AlexGyver/GyverControl/docs/pinout.jpg

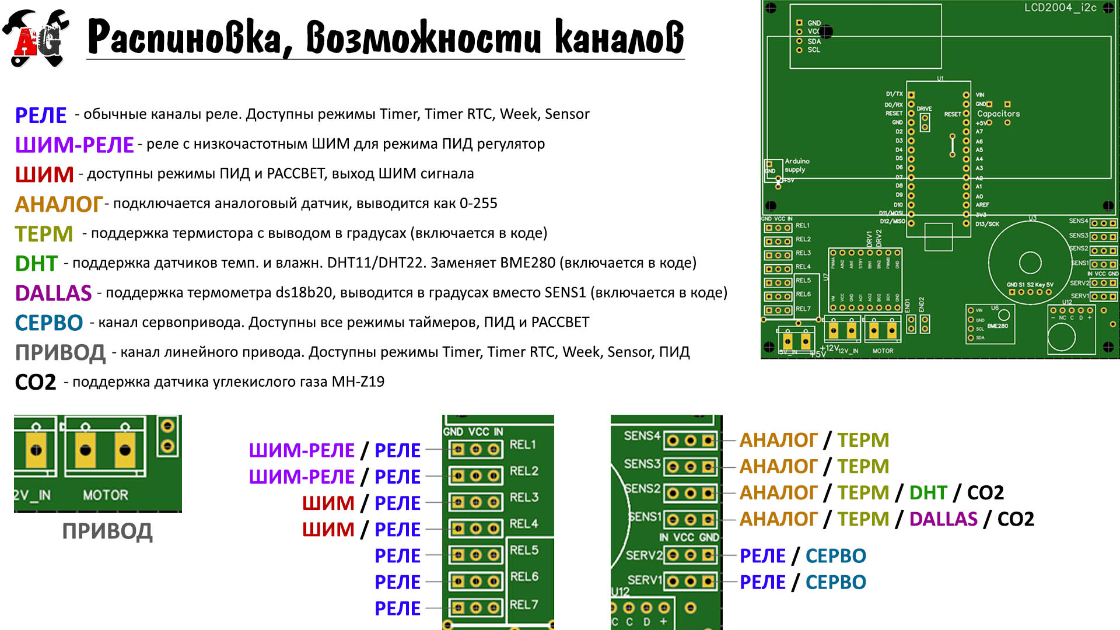
docs/pinout.jpg
