AlexGyver/GyverControl/docs/screen2.jpg

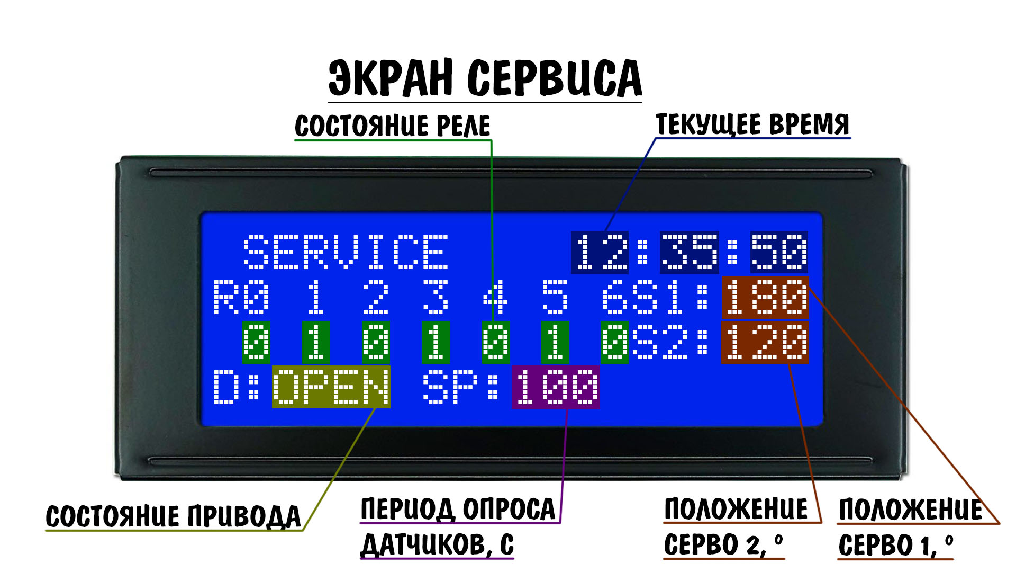
docs/screen2.jpg
