AlexGyver/GyverControl/docs/screen3.jpg

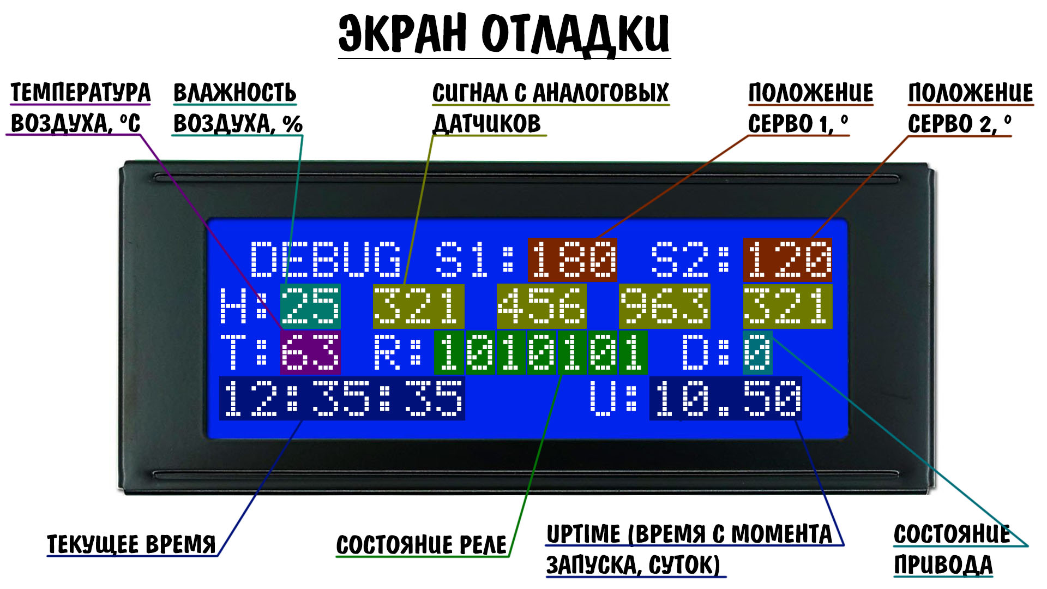
docs/screen3.jpg
