AlexGyver/GyverControl/docs/screen4.jpg

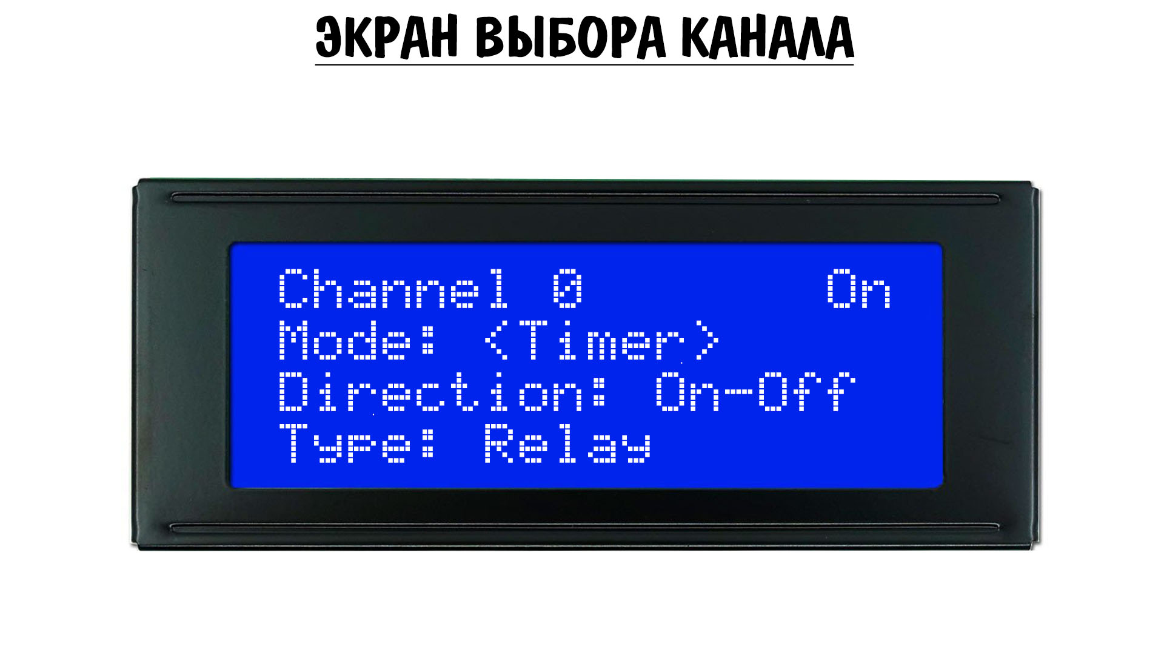
docs/screen4.jpg
