AlexGyver/GyverControl/docs/screen5.jpg

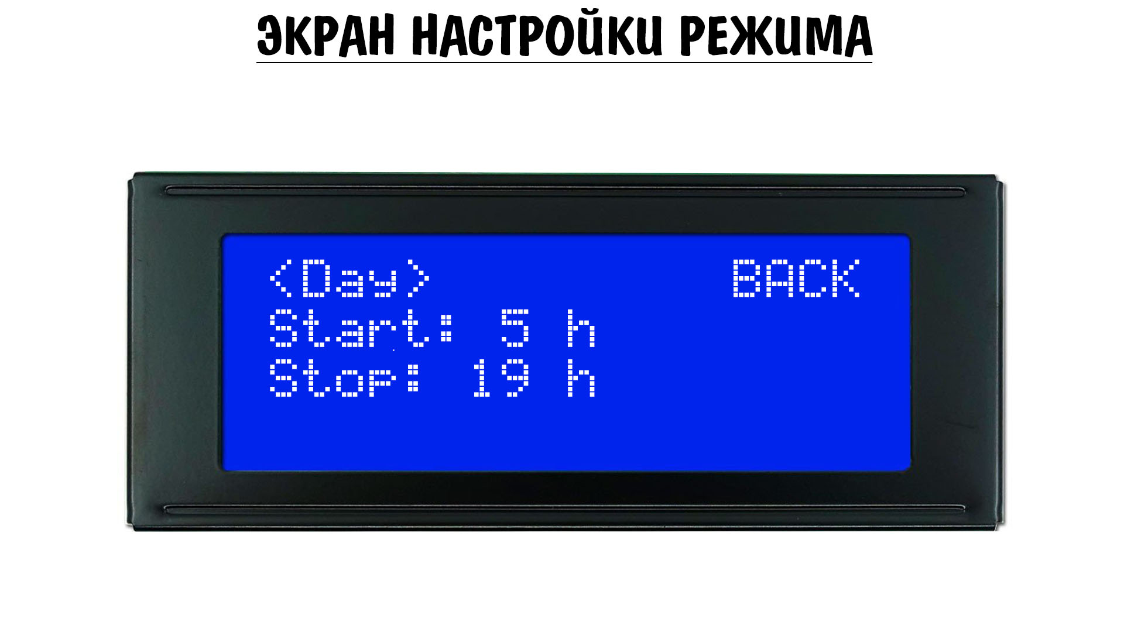
docs/screen5.jpg
