AlexGyver/GyverControl/docs/screen6.jpg

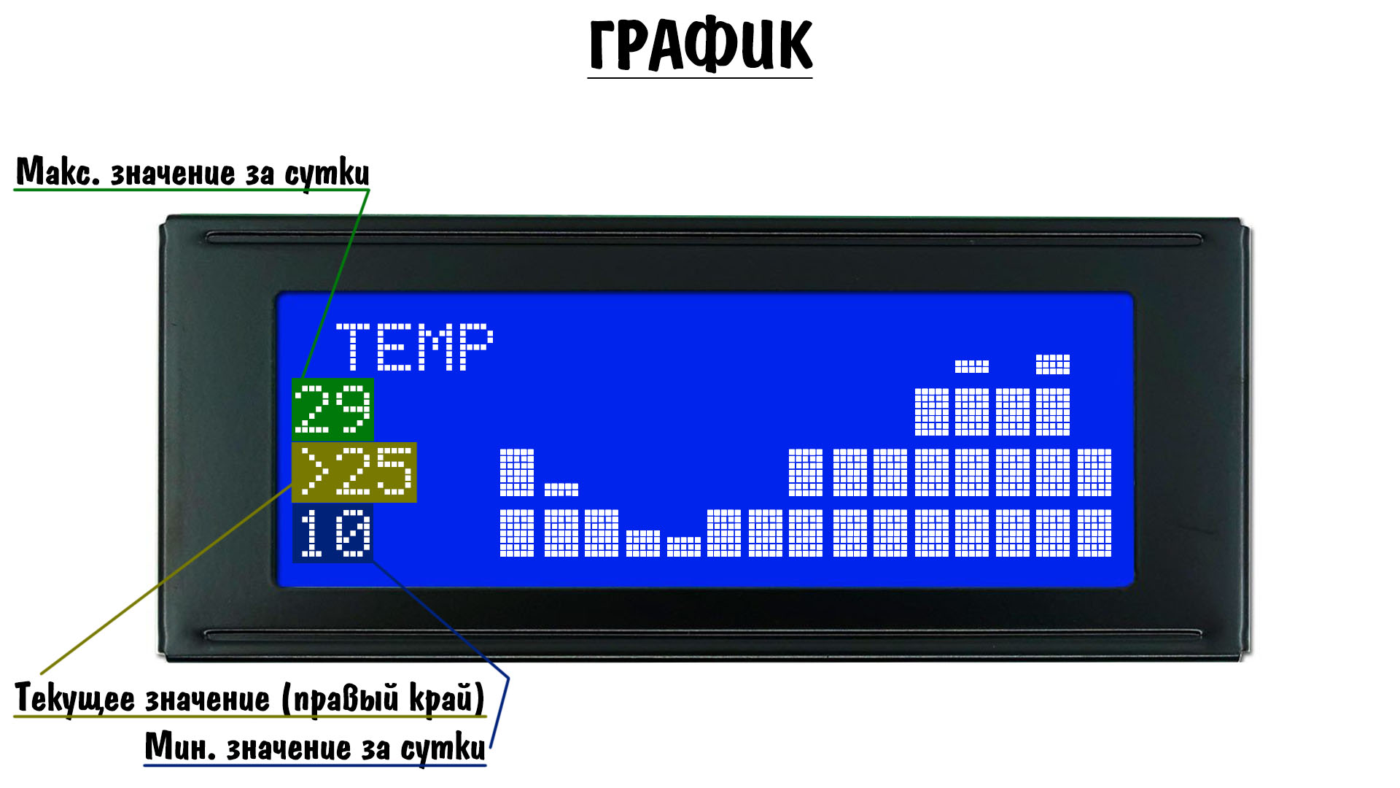
docs/screen6.jpg
