AlexGyver/GyverControl/docs/screen7.jpg

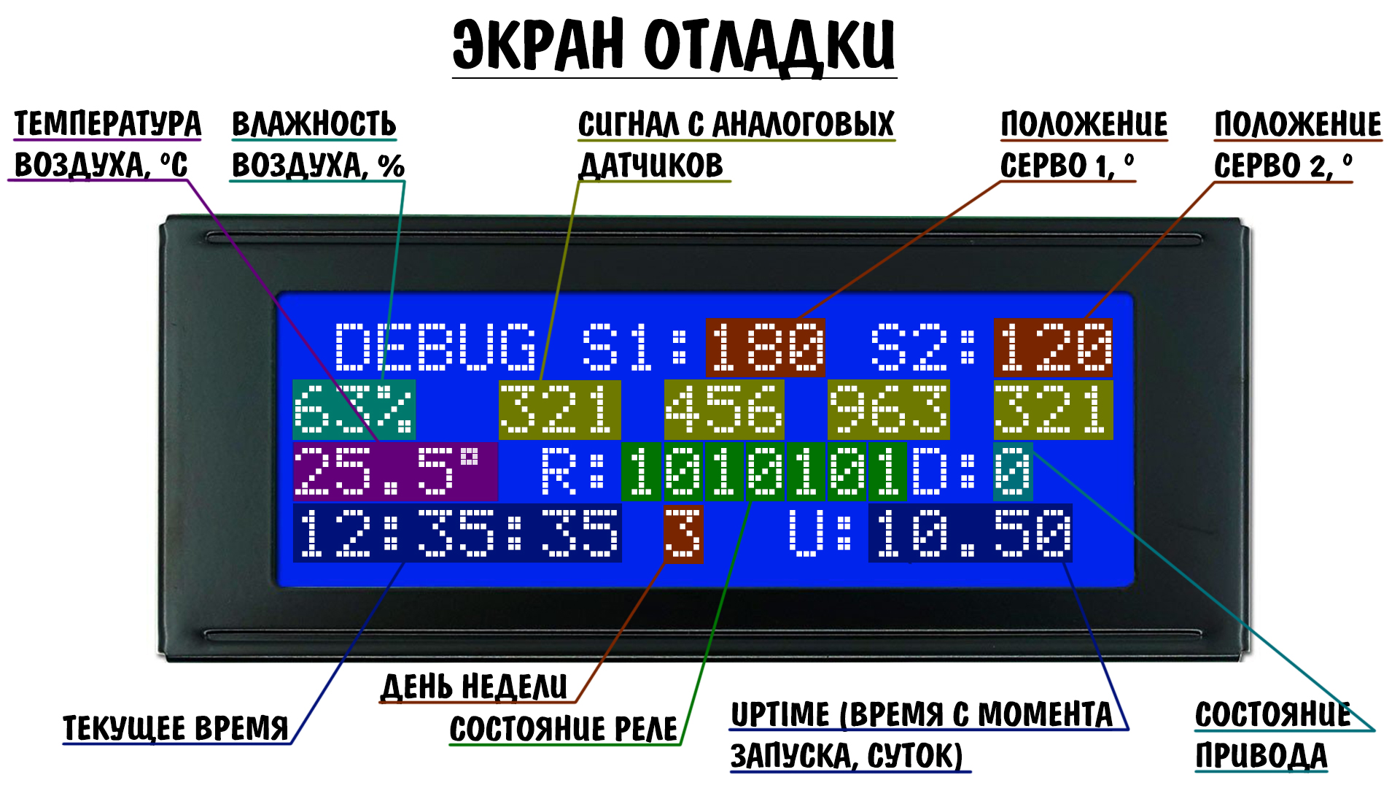
docs/screen7.jpg
