AlexGyver/GyverControl/schemes/scheme2.jpg

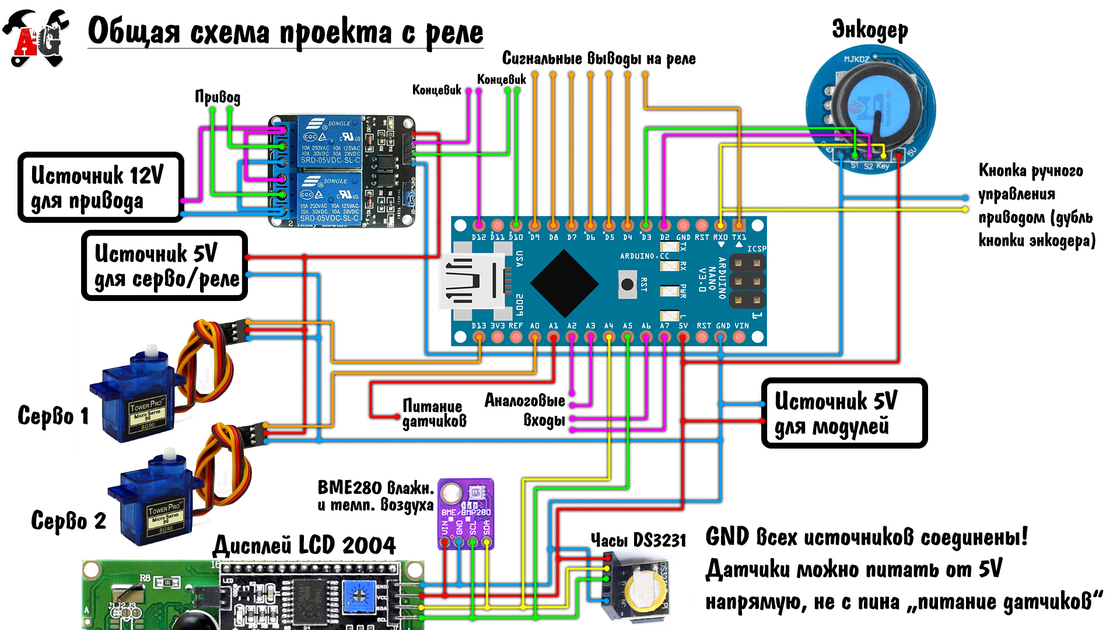
schemes/scheme2.jpg
