AlexGyver/GyverControl/schemes/scheme7.jpg

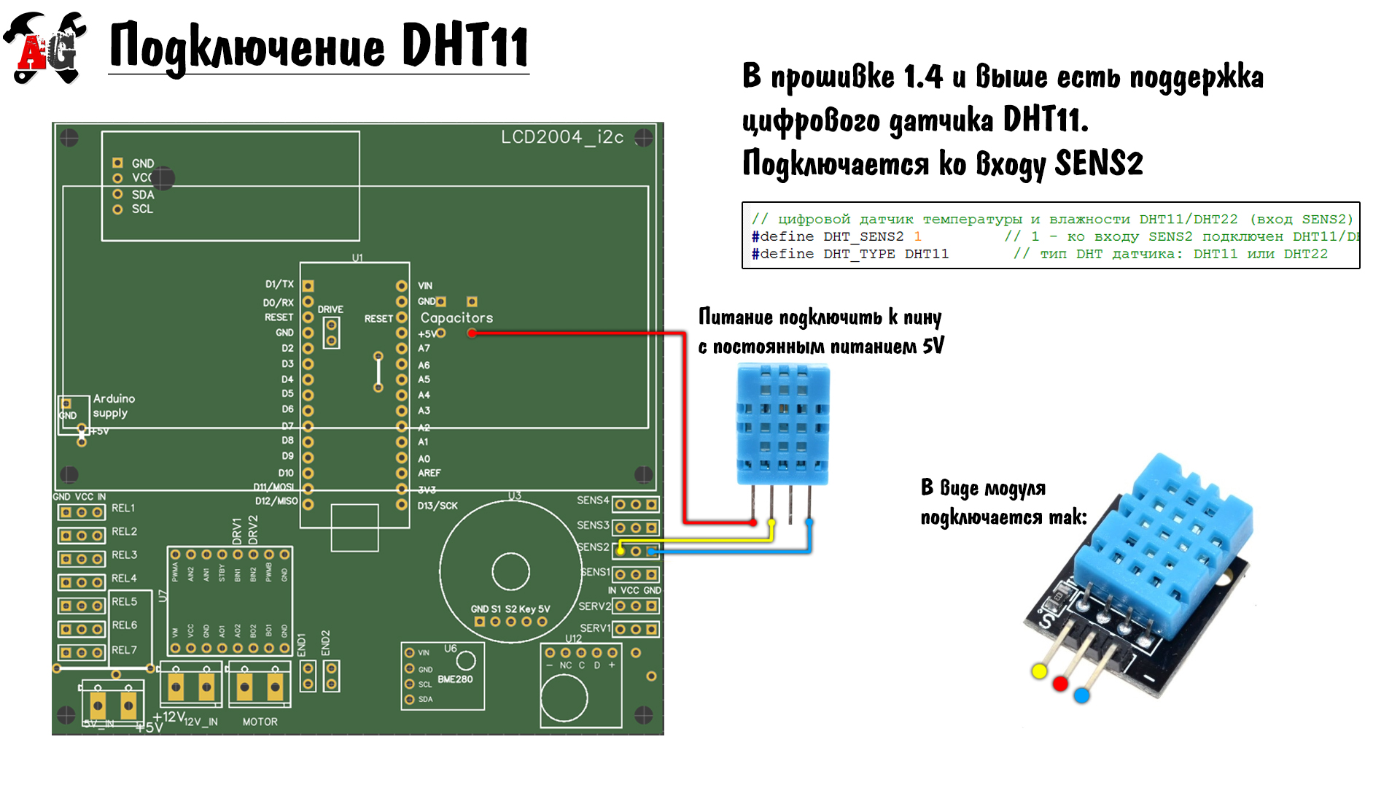
schemes/scheme7.jpg
