AlexGyver/GyverControl/schemes/scheme8.jpg

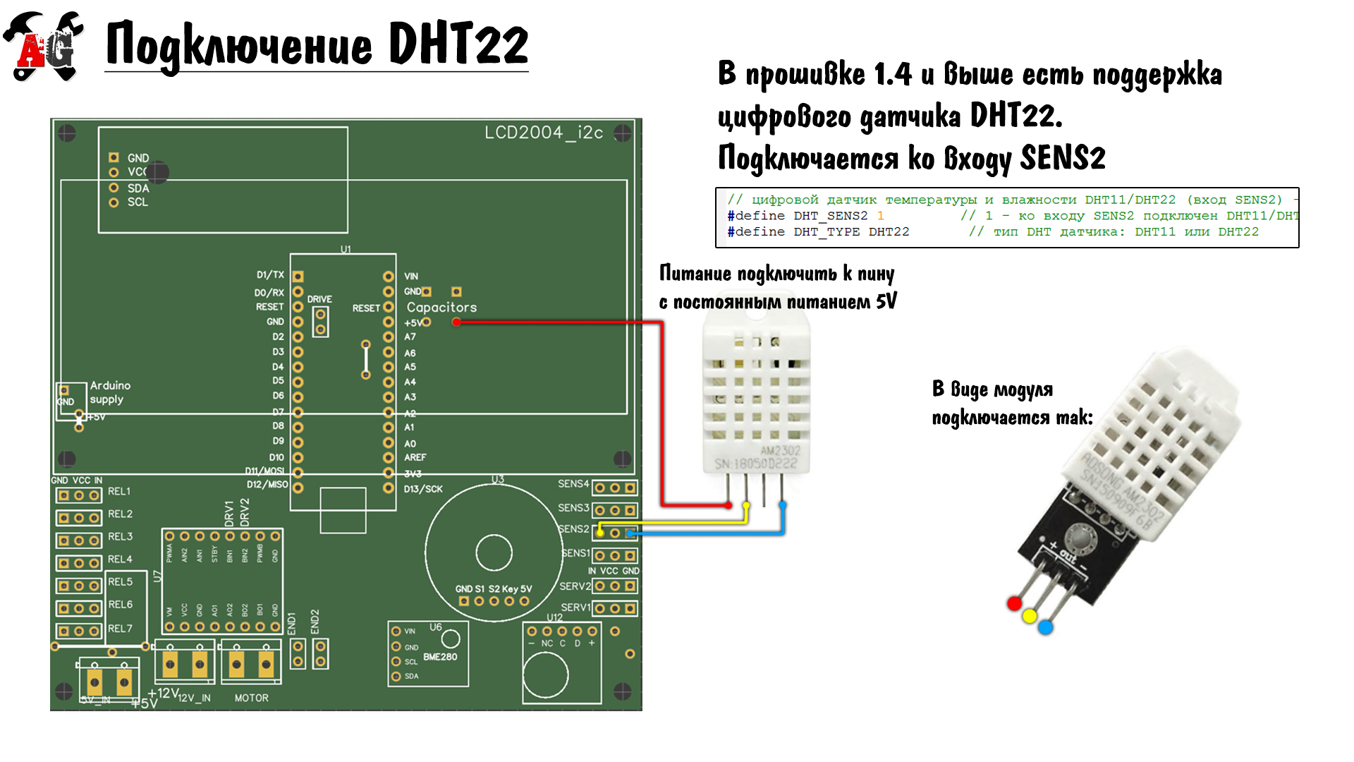
schemes/scheme8.jpg
