AlexGyver/GyverControl/schemes/scheme9.jpg

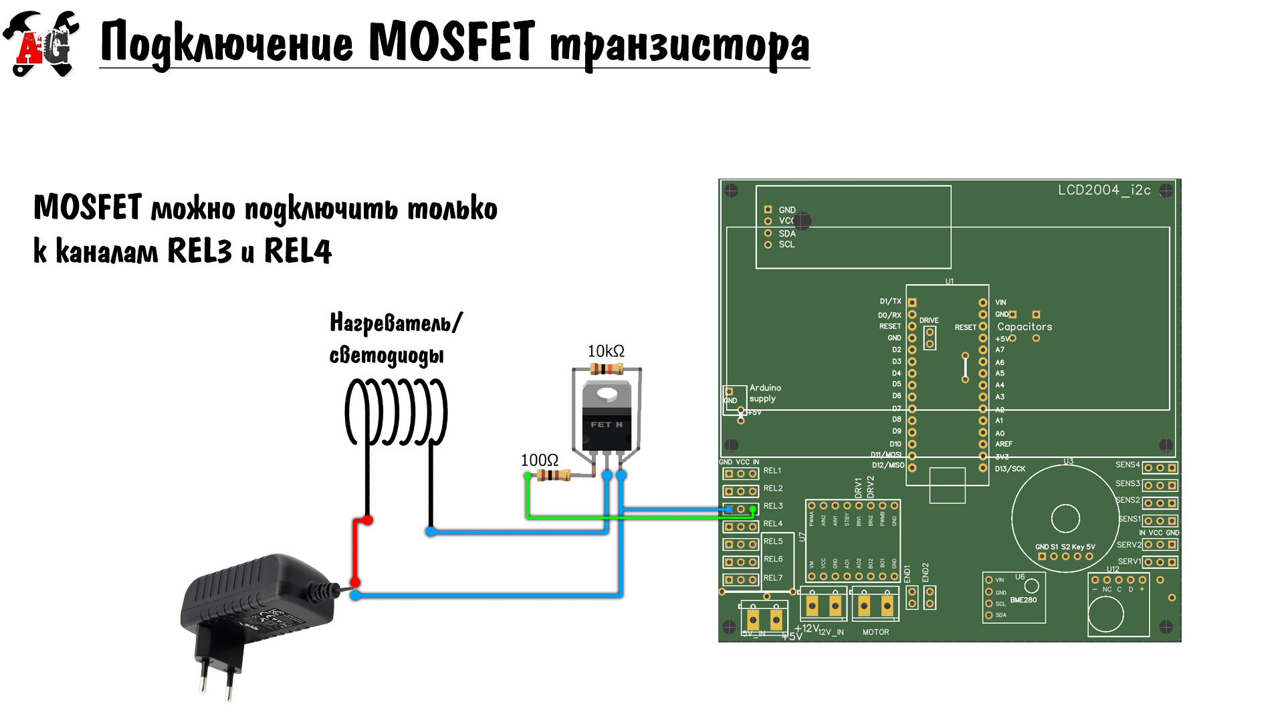
schemes/scheme9.jpg
