AlexGyver/GyverControl/schemes/scheme12.jpg

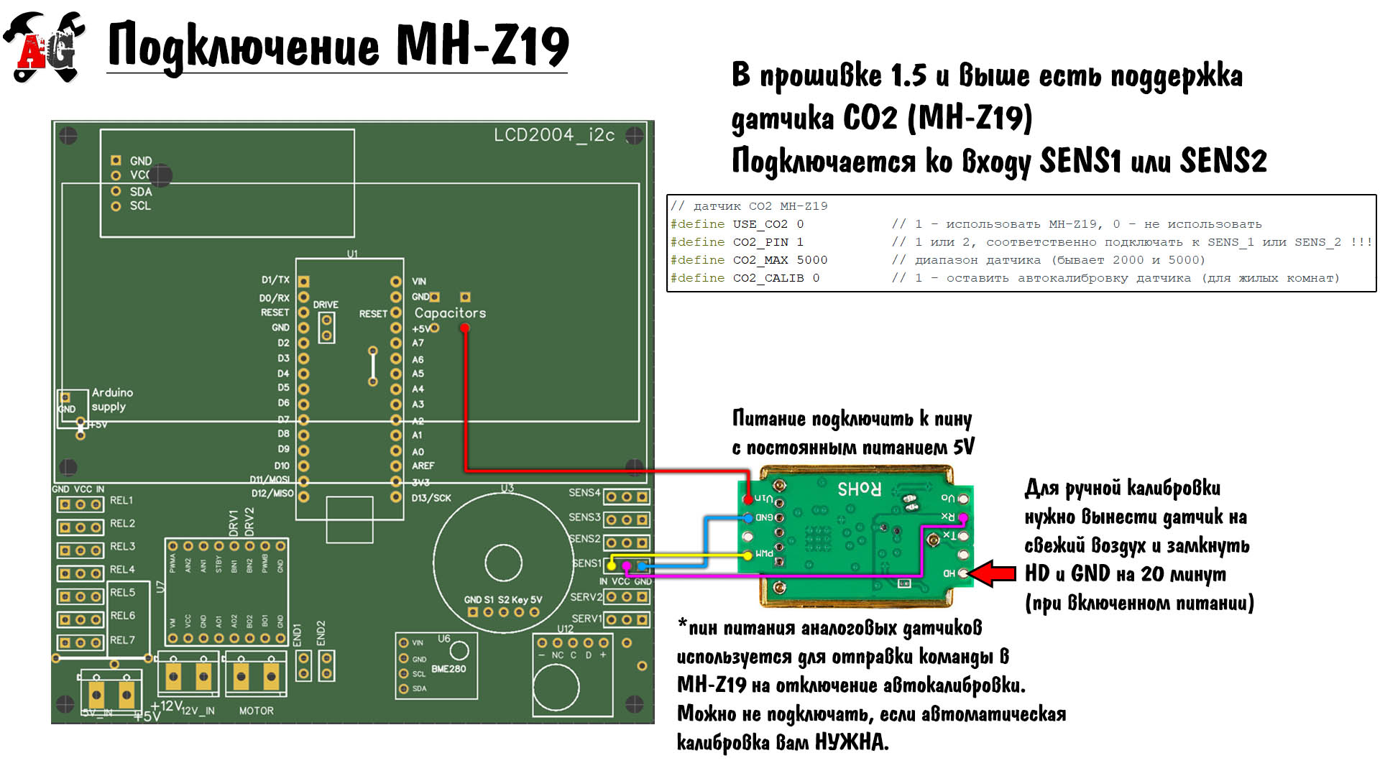
schemes/scheme12.jpg
