AlexGyver/GyverControl/schemes/scheme13.jpg

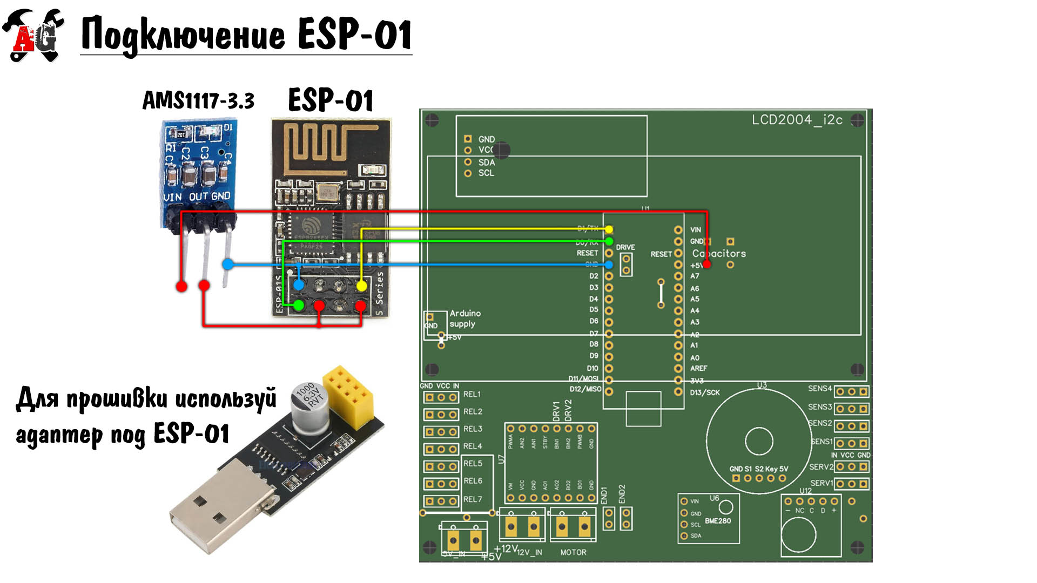
schemes/scheme13.jpg
