AlexGyver/GyverControl/schemes/scheme14.jpg

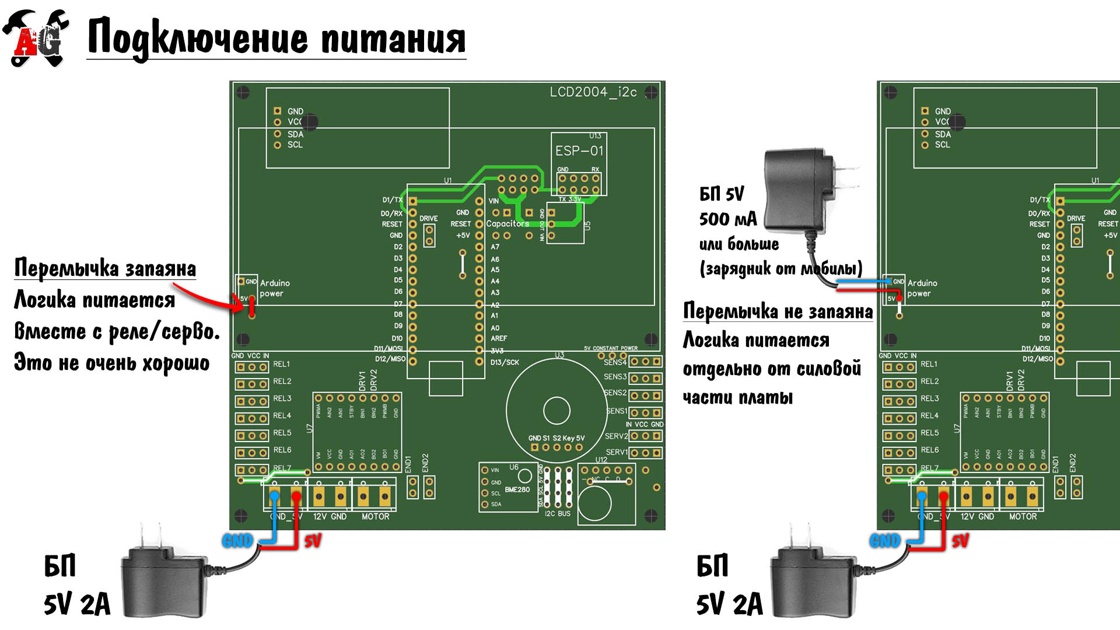
schemes/scheme14.jpg
