AlexGyver/GyverControl/schemes/scheme15.jpg

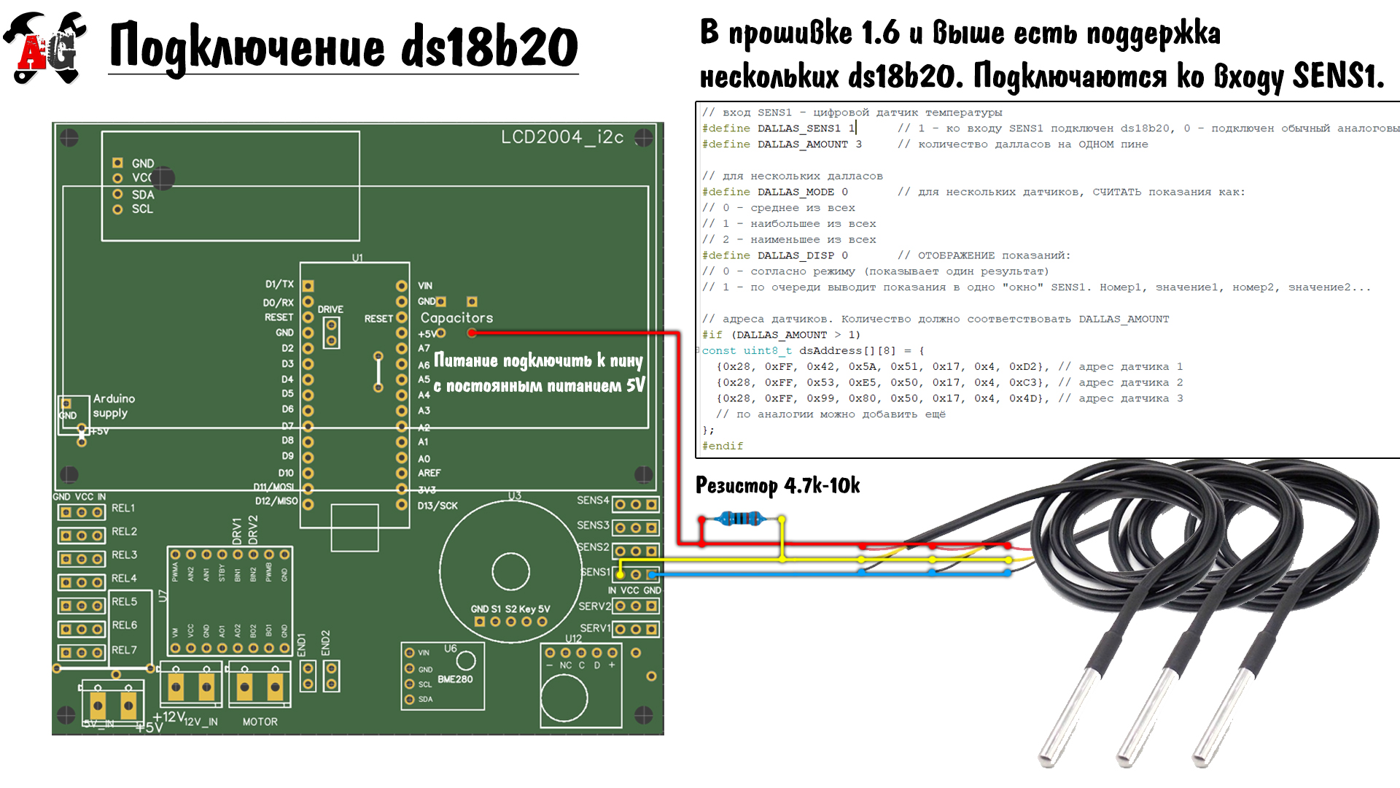
schemes/scheme15.jpg
