AlexGyver/GyverControl/schemes/scheme16.jpg

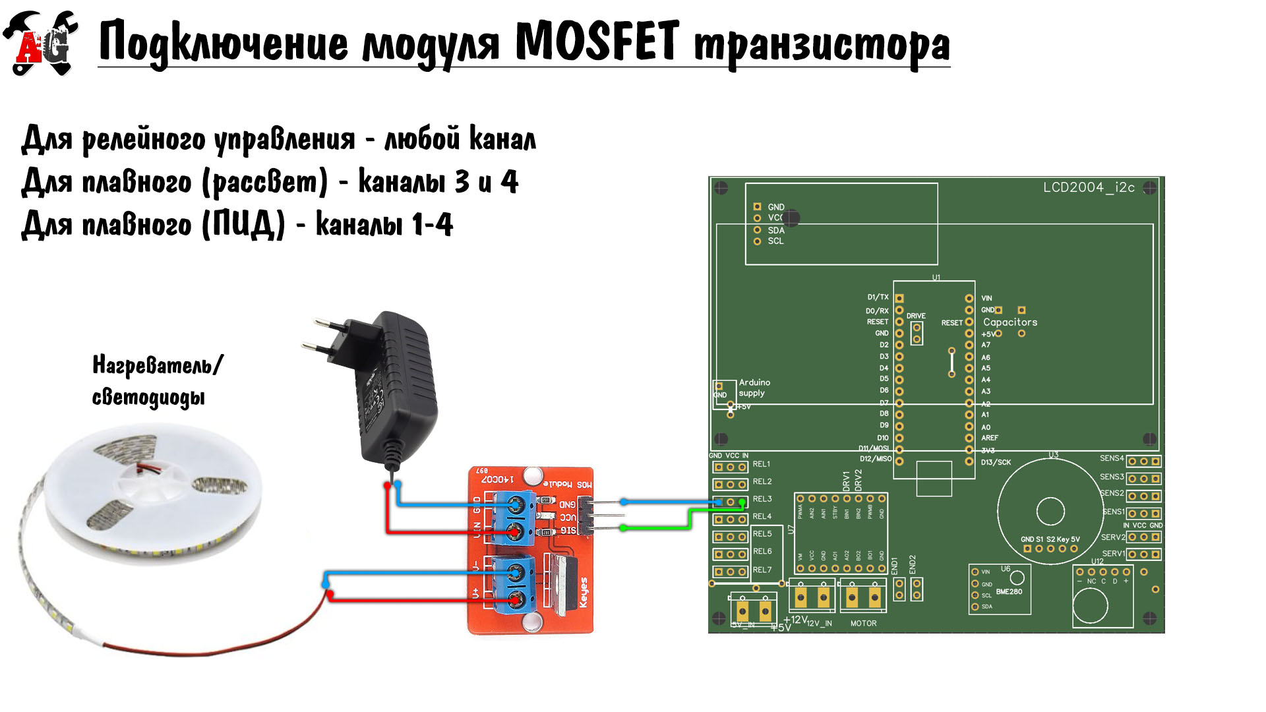
schemes/scheme16.jpg
