AlexGyver/GyverControl/schemes/usbasp.jpg

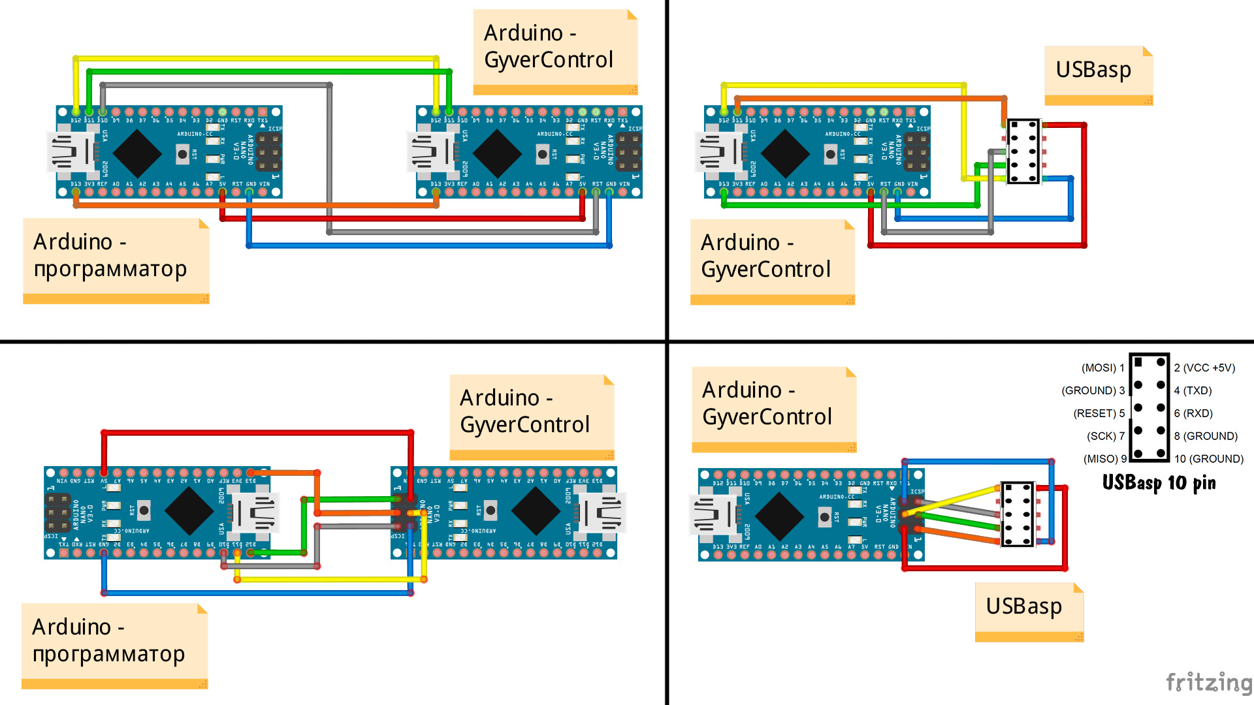
schemes/usbasp.jpg
