AlexGyver/GyverControl/(threads)

Thread 3 (2019-06-24):

Осмысленные комментарии

DrPreobrazhensky, 2019-06-24:
Спасибо за проект.

Будьте добры впредь писать более-менее осмысленные комментарии к коммитам.

Заранее спасибо.

AlexGyver, 2019-06-29:
Список изменений всегда находится в шапке основного файла прошивки. Любые изменения появляются в новой версии, старые версии не меняются. Поэтому все комментарии - upd или add

XRay3D, 2019-12-04:
У меня так вообще часто просто дата и время в коммите.

Thread 5 (2021-07-23):

Баг с отключением подсветки экрана в меню DEBUG

Igor-bite, 2021-07-23:
Когда отключается подсветка экрана в меню DEBUG всё просто перестаёт работать и при нажатии или повороте энкодера ничего не происходит. В других менюшках всё работает нормально.

Igor-bite, 2021-07-23:
Я немного дебажил и нашёл строчку, на которой всё валится: функция `redrawDebug`, строчка `lcd.setCursor(1, 0);` выполняется, а вот на строчке `lcd.print("DEBUG");` всё фризится.

Thread 6 (2021-11-12):

Проблема с компиляцией прошивки. (microWire.h:23:7: error: redefinition of 'class TwoWire')

Comvideo, 2021-11-12:
При компиляции возникает ошибка :
Библиотека microWire установлена
Поиск ошибки не дал результатов((
Помогите решить проблему или подскажите где спросить ))
[error.txt](https://github.com/AlexGyver/GyverControl/files/7530601/error.txt)

Comvideo, 2021-11-25:
Вопрос решен. Как говорится - "сам дурак"))

Comvideo, 2021-11-25:
Всем спасибо, война окончена!)

Closed 2021-11-25.

Thread 8 (2022-10-08):

Использование минимального класса для энкодера

brightproject, 2022-10-08:
Изучаю код для [контроллера](https://github.com/AlexGyver/GyverControl/tree/master/firmware/GyverControl_1.6.3), обратил внимание, что используется библиотека  "encMinim.h"
Судя из названия, это облегченная библиотека, и в ней команды от энкодера преобразуются в цифры от 0 до 6.
`// 0 - ничего, 1 - лево, 2 - право, 3 - правоНажат, 4 - левоНажат, 5 - клик, 6 - удержан`
Также

Thread 9 (2022-10-09):

Для пунктов меню лучше использовать логику CASE или IF

brightproject, 2022-10-09:
Ищу оптимальный код для своего меню.
Перелопатил с десяток примеров, и обратил внимание, что во многом коде меню, пункты записаны массивом

```
const char *channelNames[] = {
  "Channel 1",
  "Channel 2",
  "Channel 3",
  "Channel 4",
  "Channel 5",
  "Channel 6",
  "Channel 7",
  "Servo 1",
  "Servo 2",
  "Drive",
};
```
или

```
char *menuTxt[] = {"Temperature","Humidity","Both","Battery","Backlight","Contrast","EEPROM dump","Graph","Help","Reboot"};
```

А в некоторых, зашиты жестко в коде

```
  switch (menu) {
    case 0:
      menu = 1;
      break;
    case 1:
      lcd.clear();
      lcd.print(">MenuItem1");
      lcd.setCursor(0, 1);
      lcd.print(" MenuItem2");
      break;
    case 2:
      lcd.clear();
      lcd.print(" MenuItem1");
      lcd.setCursor(0, 1);
      lcd.print(">MenuItem2");
      break;
    case 3:
      lcd.clear();
      lcd.print(">MenuItem3");
      lcd.setCursor(0, 1);
      lcd.print(" MenuItem4");
      break;
    case 4:
      lcd.clear();
      lcd.print(" MenuItem3");
      lcd.setCursor(0, 1);
      lcd.print(">MenuItem4");
      break;
    case 5:
      menu = 4;
      break;
  }
```
И здесь вопрос собственно - что предпочтительнее использовать конструкцию SWITCH-CASE или IF-ELSE?

```
switch (var) {
    case 1:
      //выполняется, когда var равно 1
      break;
    case 2:
      //выполняется когда  var равно 2
      break;
    default:
      // выполняется, если не выбрана ни одна альтернатива
      // default необязателен
  }
```
```
  if(var=1) //выполняется, когда var равно 1;
  if(var=2) //выполняется, когда var равно 2;
```
Вопрос эстетики или действительно важно применять ту или иную конструкцию?
В более поздних примерах кода из интернете(до 2017 года) применяют больше IF-ELSE.
В свежих примерах(с 2018 и до нг) чаще встречаю SWITCH-CASE.

GmDio, 2023-05-28:
Я использую IF ELSE, мне так удобнее, а так кажется вряд ли кто-то ответит на этот вопрос. Не думаю, что будет какой-то прям выигрыш в быстродействии того или иного выбора, а вымерять микросекунды, ну такое...
