AlexGyver/GyverControl/firmware/GyverControl_1.6.3/a0_changelog.ino

/*
  ===== Версия 1.6 =====
  - Облегчённые библиотеки:
    - Для часов используется библиотека microDS3231
    - Для дисплея используется библиотека microLiquidCrystal_I2C
    - Для ds18b20 используется библиотека microDS18B20
    - Для BME280 используется библиотека GyverBME280
  - Чуть оптимизации кода
  - Исправлен баг с выводом инверсных состояний реле в окне DEBUG
  - Добавлена возможность работы с отрицательными температурами в режиме Sensor
  - Исправлено незапоминание настроек SP и PP в Service
  - ServoSmooth обновлена, работа серво улучшена
  - Исправлен баг с сохранением настроек
    - Ваши настройки при переходе на 1.5 будут сброшены!
  - В ПИД установка переделана на десятичные дроби
  - BME и Dallas выводят температуру в десятичных дробях
  - Шаги настроек изменены на более мелкие
  - Исправлена настройка времени в сервисе
  - Добавлен режим ПИД для каналов 1 и 2 (низкочастотный ШИМ). Каналы помечены *
  - Для "обратного" режима ПИД нужно ставить отрицательные коэффициенты!
  - В недельке можно выбрать время включения меньше времени выключения
  - Ещё оптимизация памяти
  - Добавлен "быстрый поворот" энкодера: шаг изменения значения увеличивается при быстром вращении
  - Чуть оптимизирован ПИД
  - Значения с точкой в графиках
  - Автоматический масштаб графика
  - Переделана структура меню настроек
  - Добавлена настройка даты в меню настроек
  - Воскресенье теперь цифра 7 (было 0)
  - Исправлена настройка времени в Timer RTC
  - Корректное отображение и работа каналов Servo, работающих как реле
  - Улучшена работа ПИД
  - Добавлены названия для доп. датчиков, улучшено оформление
  - Период опроса и период графиков перенесены в настройки
  - ЕЩЁ БОЛЬШЕ ОПТИМИЗАЦИИ
  - Добавлена поддержка датчика угл. газа MH-Z19. Есть возможность отключить автокалибровку.
  - Исправлена ошибка в графиках
  - ПИД и РАССВЕТ переделаны в линейное меню
  - Оптимизированы графики
  - Добавлена возможность отключить плавность серво для облегчения памяти
  - Оптимизация памяти и вывода на дисплей
  - Исправлен косяк с приводом при выходе из сервиса
  - Небольшие изменения в окне сервиса
  - Добавлено стартовое меню с сервисом и сбросом (включается по желанию)
  - Небольшая оптимизация памяти
  - Исправлено отображение реле с низким уровнем в сервисе
  - Добавлено расписание для ПИД. Ежедневное и на период в днях
  - Исправлен косяк с подсветкой
  - Исправлены критические ошибки с серво (пид и рассвет)
  - ИСПРАВЛЕНЫ ОШИБКИ С СОХРАНЕНИЕМ НАСТРОЕК
  - Сильная оптимизация оперативной памяти
  - Графики теперь сохраняются за все периоды (15 дней, 15 часов, 15 минут)
  - При выборе датчика значения сразу приравниваются к его показанию (pid, sensor)
  - Добавлен режим отладки ПИД (вывод графиков на ПК)
  - Небольшая оптимизация рассвета
  - Исправлен BME280 для отрицательных температур (обнови библиотеку)
  - Добавлена настройка направления серво для ПИД (на главной вкладке серво, Direction)
  - Система теперь знает, что дверь была открыта в ручном режиме и работает корректно
  - Добавлено ограничение интегральной составляющей в ПИД
  - Редизайн списка настроек
  - Добавлен автотюнер ПИД
  - Добавлена поддержка нескольких ds18b20 с разными режимами работы
  - Улучшена стабильность ds18b20 (библиотека обновилась)
  - В режиме Sensor система работает при выставлении одинаковых значений порога
  - Исправлена ошибка, связывающая каналы серво и реле
  - В ПИД регуляторе для инертных систем есть смысл поднять T, логика работы чуть изменилась
  - Установка таймаута привода в десятых секунды
  - Улучшена отзывчивость и точность энкодера

  1.6.1
  - Увеличен лимит таймаута привода
  - При переходе настройки сбросятся!

  1.6.2 - добавлена поддержка HTU21D (заменяет BME280)
  1.6.3 - исправлена ошибка с серво (ошибка компиляции была)
*/
