AlexGyver/GyverControl/firmware/GyverControl_1.6.3/pwmrelay.ino

#if (USE_PID_RELAY == 1)
void tickPWM(byte ch, bool &flag, uint32_t &tmr) {
  activeChannel = loadChannel(ch);
  if (activeChannel.mode == 4 && !serviceFlag) {
    if (millis() - tmr >= (flag ? PWMactive[ch] : (PWMperiod - PWMactive[ch]))) {
      tmr = millis();
      flag = !flag;
      digitalWrite(relayPins[ch], flag ^ activeChannel.direction);
    }
  }
}
#endif
