AlexGyver/GyverControl/firmware/GyverControl_1.6.3/custom.ino

/*
  На данной вкладке можно вручную дописать контроллеру дополнительные возможности.
  - Можно использовать пины D1, D4, D5, D6, D7, D8, D9 как цифровые ВЫХОДЫ и ВХОДЫ
  - Соответствующие каналы нужно отключить из меню дисплея (-> Off), иначе работать не будет
  - В customSetup нужно инициализировать выход как INPUT/OUTPUT
*/

void customSetup() {
  // инициализация для собственных алгоритмов работы

}

void customLoop() {
  // вызывается вместе с основным loop

}
