AlexGyver/GyverControl/(commit log)

2020-03-05 Update Gerber_GyverControl PCB.zip
2020-03-05 Create Gerber_GyverControl PCB.zip.zip
